maarten-pennings/eMeterP1port/gen2/schematic-powered.pdf

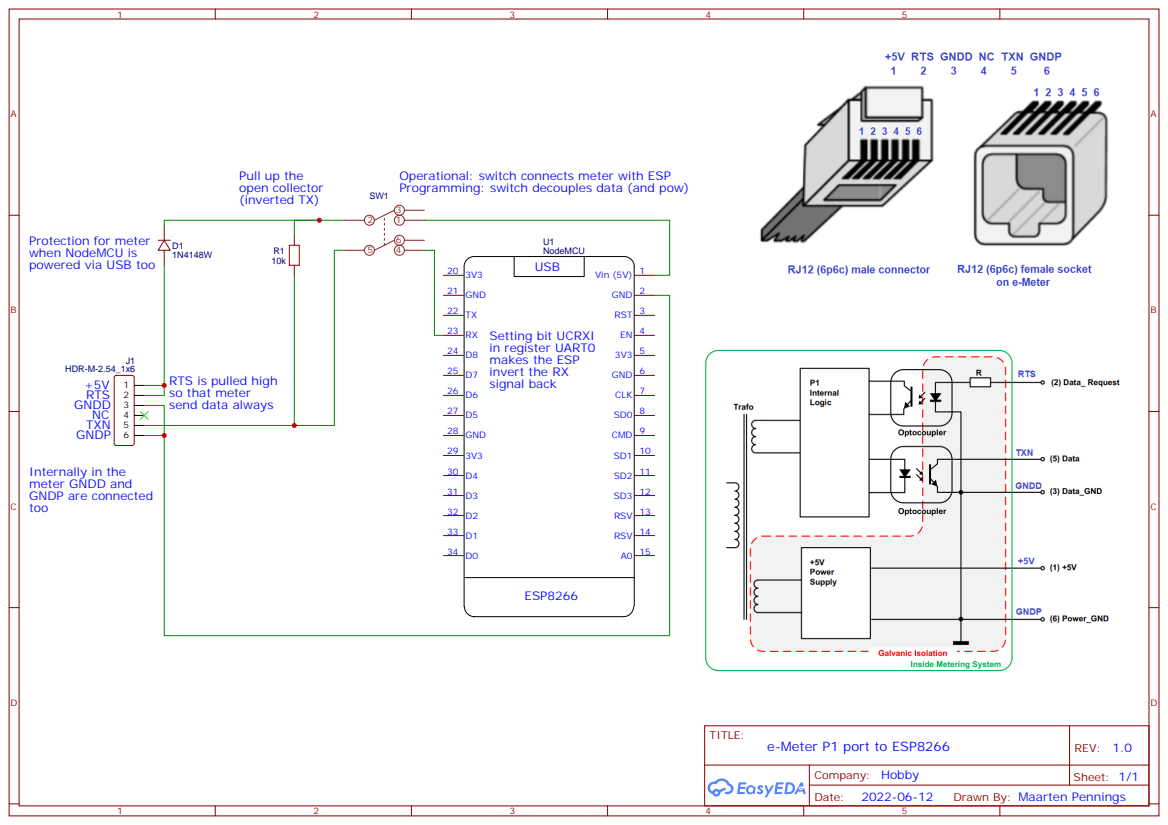
[picture p5: page 1]

Operational: switch connects meter with ESP
Programming: switch decouples data (and pow)

when NodeMCU is
powered via USB too

RTS is pulled high
so that meter
send data always

Drawn By: Maarten Pennings
