maarten-pennings/eMeterP1port/gen2/schematic-simple.pdf

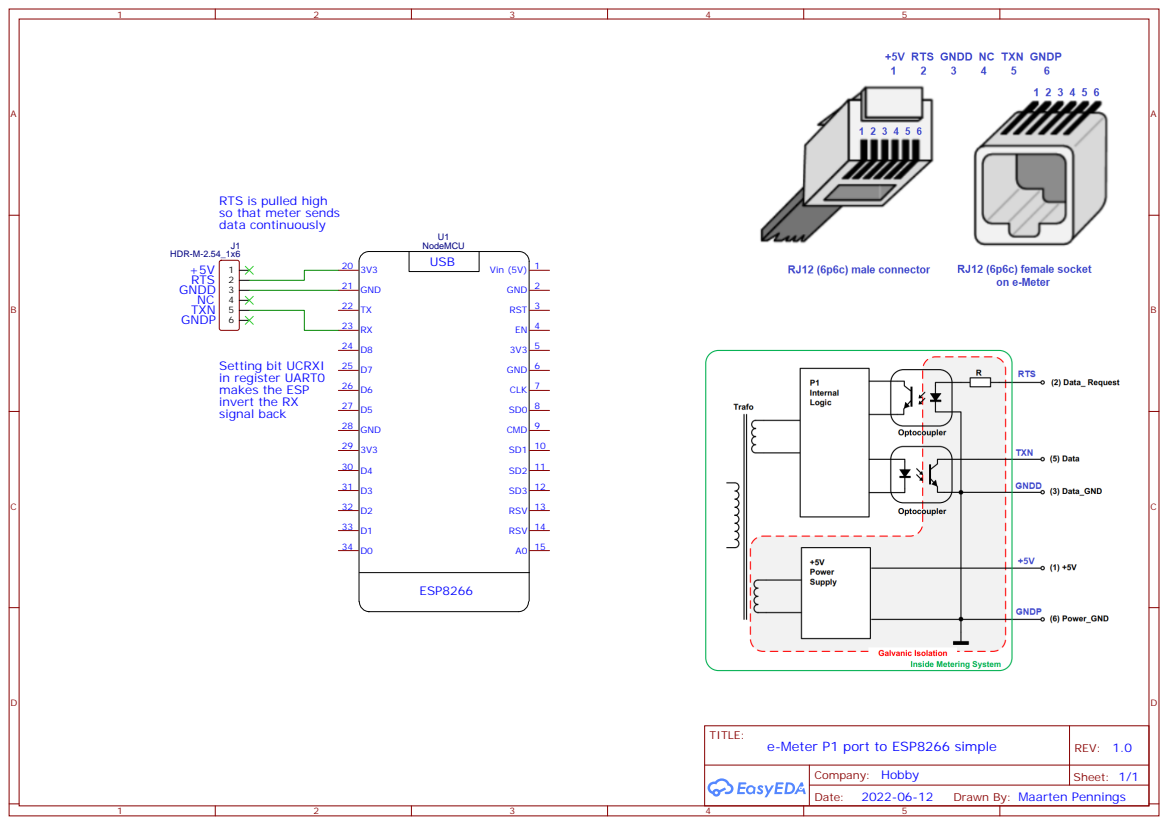
[picture p6: page 1]

Drawn By: Maarten Pennings
