maarten-pennings/eMeterP1port/(commit log)

2020-03-12 4 pin
2021-04-27 revert to BSP 2.3.0
    [emp1.ino]
2022-06-06 fixes 2 bug, adds units
    [p1parse.ino]
2022-06-12 V1.1 Changed LED behaviour
2022-06-12 fixes schematic
